Centrale-Lille-Makers/CdFdR-Carte-electronique/CdFdR.kicad_pcb

## KiCad design CdFdR.kicad_pcb (2025-05-16)

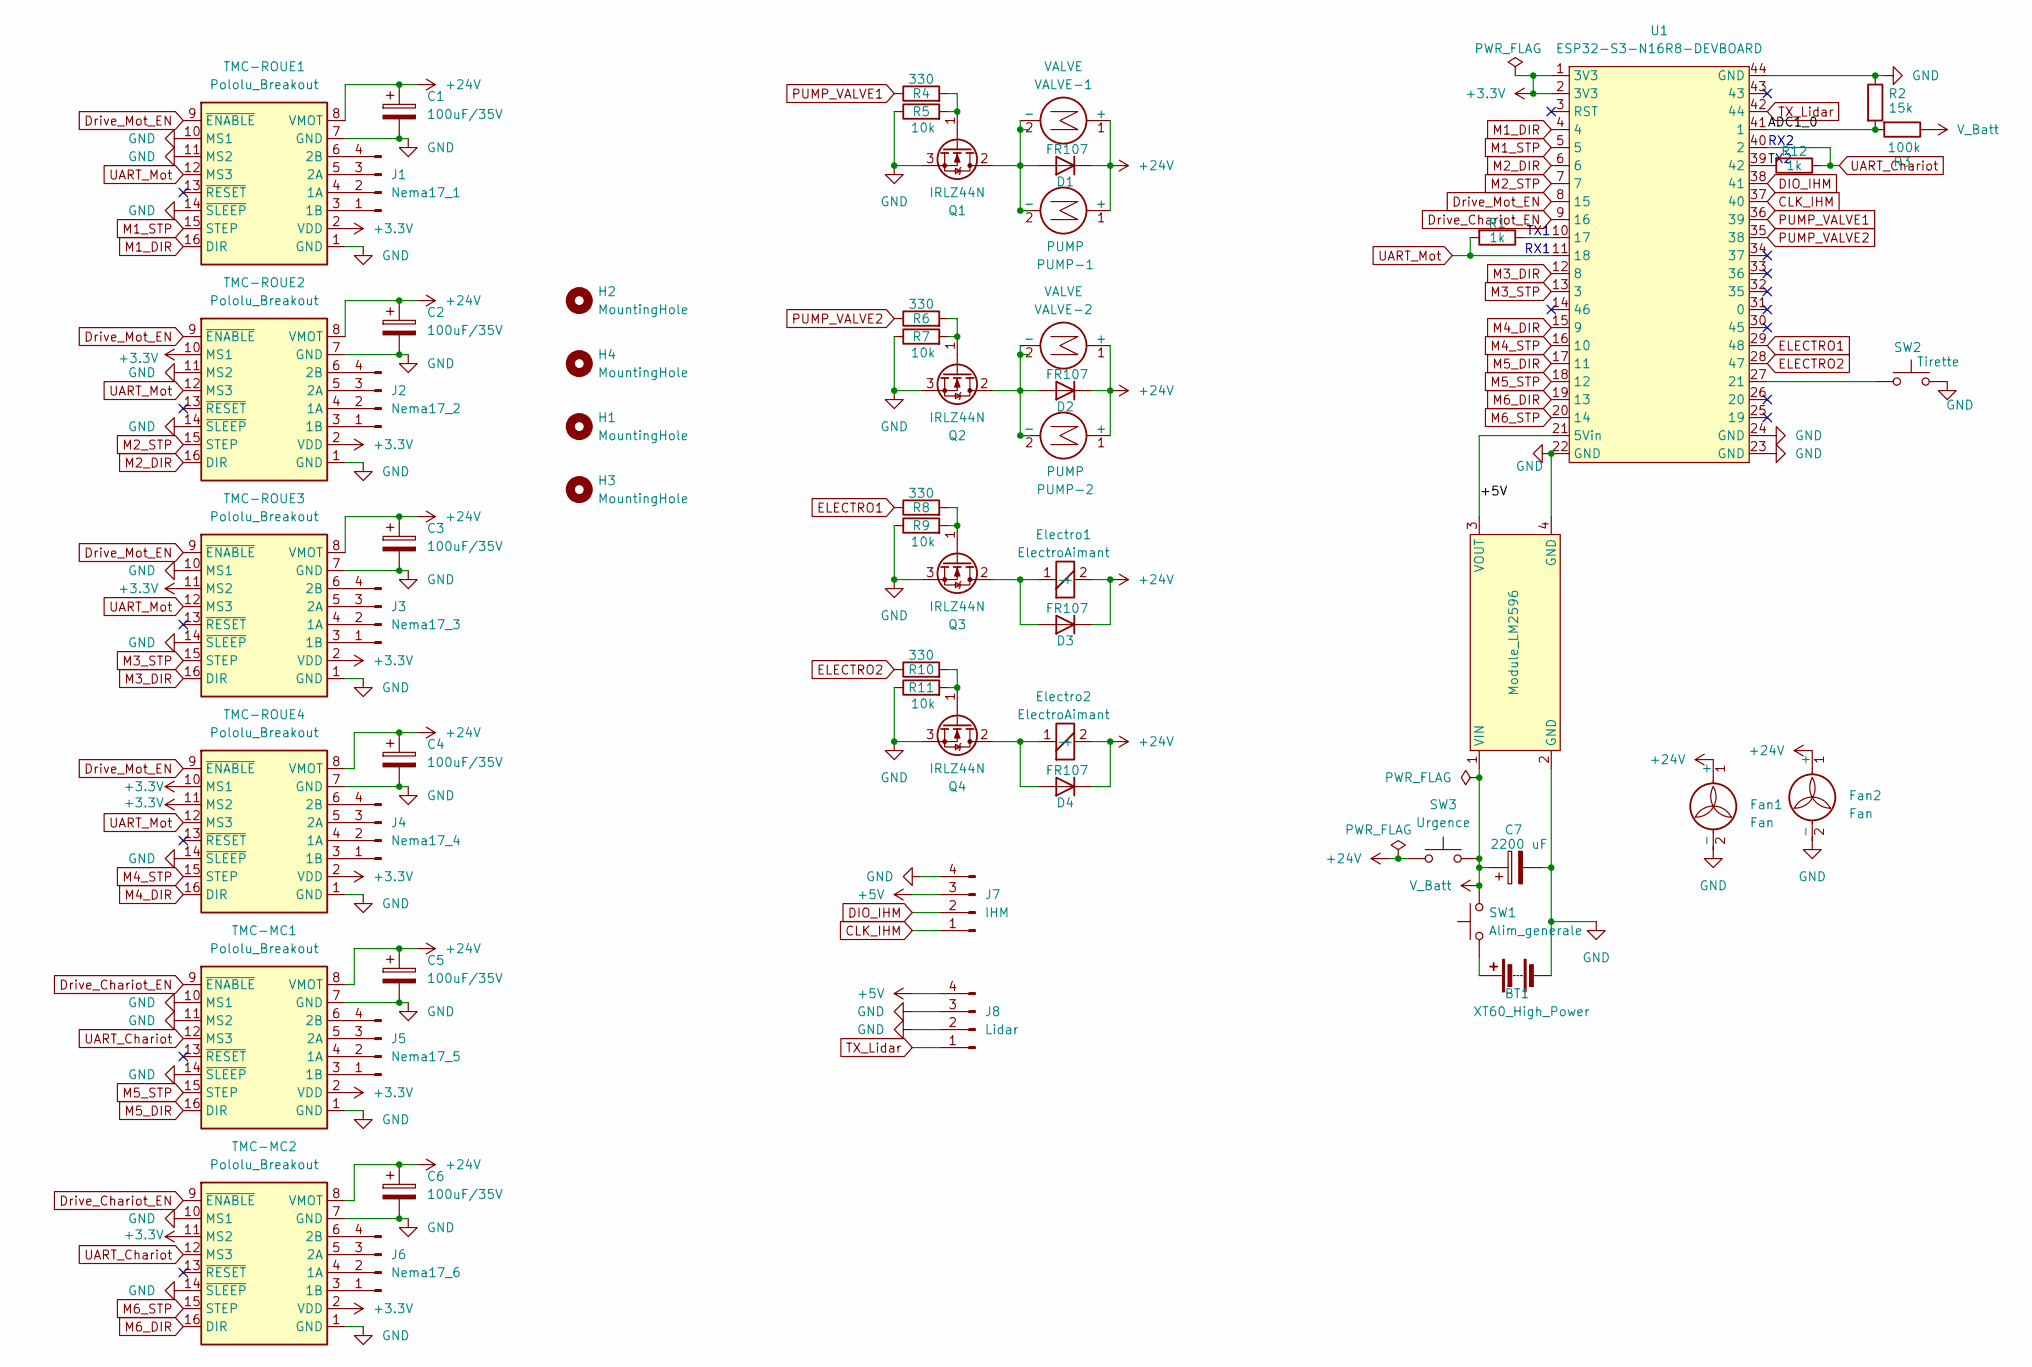
[picture p1: schematic CdFdR.kicad_sch, Carte de commande principale]

Parts:
BT1: XT60_High_Power; AMASS_XT60-M_1x02_P7.20mm_Vertical
C1, C2, C3, C4, C5, C6: 100uF/35V; CP_Radial_D6.3mm_P2.50mm
C7: 2200 uF; CP_Radial_D16.0mm_P7.50mm
D1, D2, D3, D4: FR107; D_DO-41_SOD81_P7.62mm_Horizontal
Electro1, Electro2: ElectroAimant; JST_XH_B2B-XH-A_1x02_P2.50mm_Vertical
Fan1, Fan2: Fan; JST_XH_B2B-XH-A_1x02_P2.50mm_Vertical
H1, H2, H3, H4: MountingHole; MountingHole_3.2mm_M3
J1: Nema17_1; JST_XH_B4B-XH-A_1x04_P2.50mm_Vertical
J2: Nema17_2; JST_XH_B4B-XH-A_1x04_P2.50mm_Vertical
J3: Nema17_3; JST_XH_B4B-XH-A_1x04_P2.50mm_Vertical
J4: Nema17_4; JST_XH_B4B-XH-A_1x04_P2.50mm_Vertical
J5: Nema17_5; JST_XH_B4B-XH-A_1x04_P2.50mm_Vertical
J6: Nema17_6; JST_XH_B4B-XH-A_1x04_P2.50mm_Vertical
J7: IHM; JST_XH_B4B-XH-A_1x04_P2.50mm_Vertical
J8: Lidar; JST_XH_B4B-XH-A_1x04_P2.50mm_Vertical
Module_LM2596: LM2596; LM2596 Converter DC-DC
PUMP-1, PUMP-2: PUMP; JST_XH_B2B-XH-A_1x02_P2.50mm_Vertical
Q1, Q2, Q3, Q4: IRLZ44N; TO-220-3_Vertical
R1, R12: 1k; R_Axial_DIN0207_L6.3mm_D2.5mm_P7.62mm_Horizontal
R2: 15k; R_Axial_DIN0207_L6.3mm_D2.5mm_P7.62mm_Horizontal
R3: 100k; R_Axial_DIN0207_L6.3mm_D2.5mm_P7.62mm_Horizontal
R4, R6, R8, R10: 330; R_Axial_DIN0207_L6.3mm_D2.5mm_P7.62mm_Horizontal
R5, R7, R9, R11: 10k; R_Axial_DIN0207_L6.3mm_D2.5mm_P7.62mm_Horizontal
SW1: Alim_generale; AMASS_XT60-F_1x02_P7.20mm_Vertical
SW2: Tirette; JST_XH_B2B-XH-A_1x02_P2.50mm_Vertical
SW3: Urgence; AMASS_XT60-F_1x02_P7.20mm_Vertical
TMC-MC1, TMC-MC2: Pololu_Breakout; Pololu_Breakout-16_15.2x20.3mm_Better_Silkscreen
TMC-ROUE1, TMC-ROUE2, TMC-ROUE3, TMC-ROUE4: Pololu_Breakout; Pololu_Breakout-16_15.2x20.3mm_Better_Silkscreen
U1: ESP32-S3-N16R8-DEVBOARD; ESP32-S3-DevKit
VALVE-1, VALVE-2: VALVE; JST_XH_B2B-XH-A_1x02_P2.50mm_Vertical

Connections:
+3.3V: TMC-MC1.2 (VDD), TMC-MC2.2 (VDD), TMC-MC2.11 (MS2), TMC-ROUE1.2 (VDD), TMC-ROUE2.2 (VDD), TMC-ROUE2.10 (MS1), TMC-ROUE3.2 (VDD), TMC-ROUE3.11 (MS2), TMC-ROUE4.2 (VDD), TMC-ROUE4.10 (MS1), TMC-ROUE4.11 (MS2), U1.1 (3V3), U1.2 (3V3)
+5V: J7.3, J8.4, Module_LM2596.3 (VOUT), U1.21 (5Vin)
+24V: C1.1, C2.1, C3.1, C4.1, C5.1, C6.1, D1.1 (K), D2.1 (K), D3.1 (K), D4.1 (K), Electro1.2 (+), Electro2.2 (+), Fan1.1 (+), Fan2.1 (+), PUMP-1.1 (+), PUMP-2.1 (+), SW3.1, TMC-MC1.8 (VMOT), TMC-MC2.8 (VMOT), TMC-ROUE1.8 (VMOT), TMC-ROUE2.8 (VMOT), TMC-ROUE3.8 (VMOT), TMC-ROUE4.8 (VMOT), VALVE-1.1 (+), VALVE-2.1 (+)
/ADC1_0: R2.2, R3.2, U1.41 (1)
CLK_IHM: J7.1, U1.37 (40)
DIO_IHM: J7.2, U1.38 (41)
Drive_Chariot_EN: TMC-MC1.9 (~ENABLE), TMC-MC2.9 (~ENABLE), U1.9 (16)
Drive_Mot_EN: TMC-ROUE1.9 (~ENABLE), TMC-ROUE2.9 (~ENABLE), TMC-ROUE3.9 (~ENABLE), TMC-ROUE4.9 (~ENABLE), U1.8 (15)
ELECTRO1: R8.1, U1.29 (48)
ELECTRO2: R10.1, U1.28 (47)
GND: BT1.2 (-), C1.2, C2.2, C3.2, C4.2, C5.2, C6.2, C7.2, Fan1.2 (-), Fan2.2 (-), J7.4, J8.2, J8.3, Module_LM2596.2 (GND), Module_LM2596.4 (GND), Q1.3 (S), Q2.3 (S), Q3.3 (S), Q4.3 (S), R2.1, R5.1, R7.1, R9.1, R11.1, SW2.2, TMC-MC1.1 (GND), TMC-MC1.7 (GND), TMC-MC1.10 (MS1), TMC-MC1.11 (MS2), TMC-MC1.14 (~SLEEP), TMC-MC2.1 (GND), TMC-MC2.7 (GND), TMC-MC2.10 (MS1), TMC-MC2.14 (~SLEEP), TMC-ROUE1.1 (GND), TMC-ROUE1.7 (GND), TMC-ROUE1.10 (MS1), TMC-ROUE1.11 (MS2), TMC-ROUE1.14 (~SLEEP), TMC-ROUE2.1 (GND), TMC-ROUE2.7 (GND), TMC-ROUE2.11 (MS2), TMC-ROUE2.14 (~SLEEP), TMC-ROUE3.1 (GND), TMC-ROUE3.7 (GND), TMC-ROUE3.10 (MS1), TMC-ROUE3.14 (~SLEEP), TMC-ROUE4.1 (GND), TMC-ROUE4.7 (GND), TMC-ROUE4.14 (~SLEEP), U1.22 (GND), U1.23 (GND), U1.24 (GND), U1.44 (GND)
M1_DIR: TMC-ROUE1.16 (DIR), U1.4
M1_STP: TMC-ROUE1.15 (STEP), U1.5
M2_DIR: TMC-ROUE2.16 (DIR), U1.6
M2_STP: TMC-ROUE2.15 (STEP), U1.7
M3_DIR: TMC-ROUE3.16 (DIR), U1.12 (8)
M3_STP: TMC-ROUE3.15 (STEP), U1.13 (3)
M4_DIR: TMC-ROUE4.16 (DIR), U1.15 (9)
M4_STP: TMC-ROUE4.15 (STEP), U1.16 (10)
M5_DIR: TMC-MC1.16 (DIR), U1.17 (11)
M5_STP: TMC-MC1.15 (STEP), U1.18 (12)
M6_DIR: TMC-MC2.16 (DIR), U1.19 (13)
M6_STP: TMC-MC2.15 (STEP), U1.20 (14)
unnamed: BT1.1 (+), SW1.1
unnamed: D1.2 (A), PUMP-1.2 (-), Q1.2 (D), VALVE-1.2 (-)
unnamed: D2.2 (A), PUMP-2.2 (-), Q2.2 (D), VALVE-2.2 (-)
unnamed: D3.2 (A), Electro1.1 (-), Q3.2 (D)
unnamed: D4.2 (A), Electro2.1 (-), Q4.2 (D)
unnamed: J1.1, TMC-ROUE1.3 (1B)
unnamed: J1.2, TMC-ROUE1.4 (1A)
unnamed: J1.3, TMC-ROUE1.5 (2A)
unnamed: J1.4, TMC-ROUE1.6 (2B)
unnamed: J2.1, TMC-ROUE2.3 (1B)
unnamed: J2.2, TMC-ROUE2.4 (1A)
unnamed: J2.3, TMC-ROUE2.5 (2A)
unnamed: J2.4, TMC-ROUE2.6 (2B)
unnamed: J3.1, TMC-ROUE3.3 (1B)
unnamed: J3.2, TMC-ROUE3.4 (1A)
unnamed: J3.3, TMC-ROUE3.5 (2A)
unnamed: J3.4, TMC-ROUE3.6 (2B)
unnamed: J4.1, TMC-ROUE4.3 (1B)
unnamed: J4.2, TMC-ROUE4.4 (1A)
unnamed: J4.3, TMC-ROUE4.5 (2A)
unnamed: J4.4, TMC-ROUE4.6 (2B)
unnamed: J5.1, TMC-MC1.3 (1B)
unnamed: J5.2, TMC-MC1.4 (1A)
unnamed: J5.3, TMC-MC1.5 (2A)
unnamed: J5.4, TMC-MC1.6 (2B)
unnamed: J6.1, TMC-MC2.3 (1B)
unnamed: J6.2, TMC-MC2.4 (1A)
unnamed: J6.3, TMC-MC2.5 (2A)
unnamed: J6.4, TMC-MC2.6 (2B)
unnamed: Q1.1 (G), R4.2, R5.2
unnamed: Q2.1 (G), R6.2, R7.2
unnamed: Q3.1 (G), R8.2, R9.2
unnamed: Q4.1 (G), R10.2, R11.2
unnamed: R1.1, U1.10 (17)
unnamed: SW2.1, U1.27 (21)
unnamed: R12.2, U1.39 (42)
PUMP_VALVE1: R4.1, U1.36 (39)
PUMP_VALVE2: R6.1, U1.35 (38)
TX_Lidar: J8.1, U1.42 (44)
UART_Chariot: R12.1, TMC-MC1.12 (MS3), TMC-MC2.12 (MS3), U1.40 (2)
UART_Mot: R1.2, TMC-ROUE1.12 (MS3), TMC-ROUE2.12 (MS3), TMC-ROUE3.12 (MS3), TMC-ROUE4.12 (MS3), U1.11 (18)
V_Batt: C7.1, Module_LM2596.1 (VIN), R3.1, SW1.2, SW3.2

Notes on the sheet:
TX2
RX1
TX1
RX2

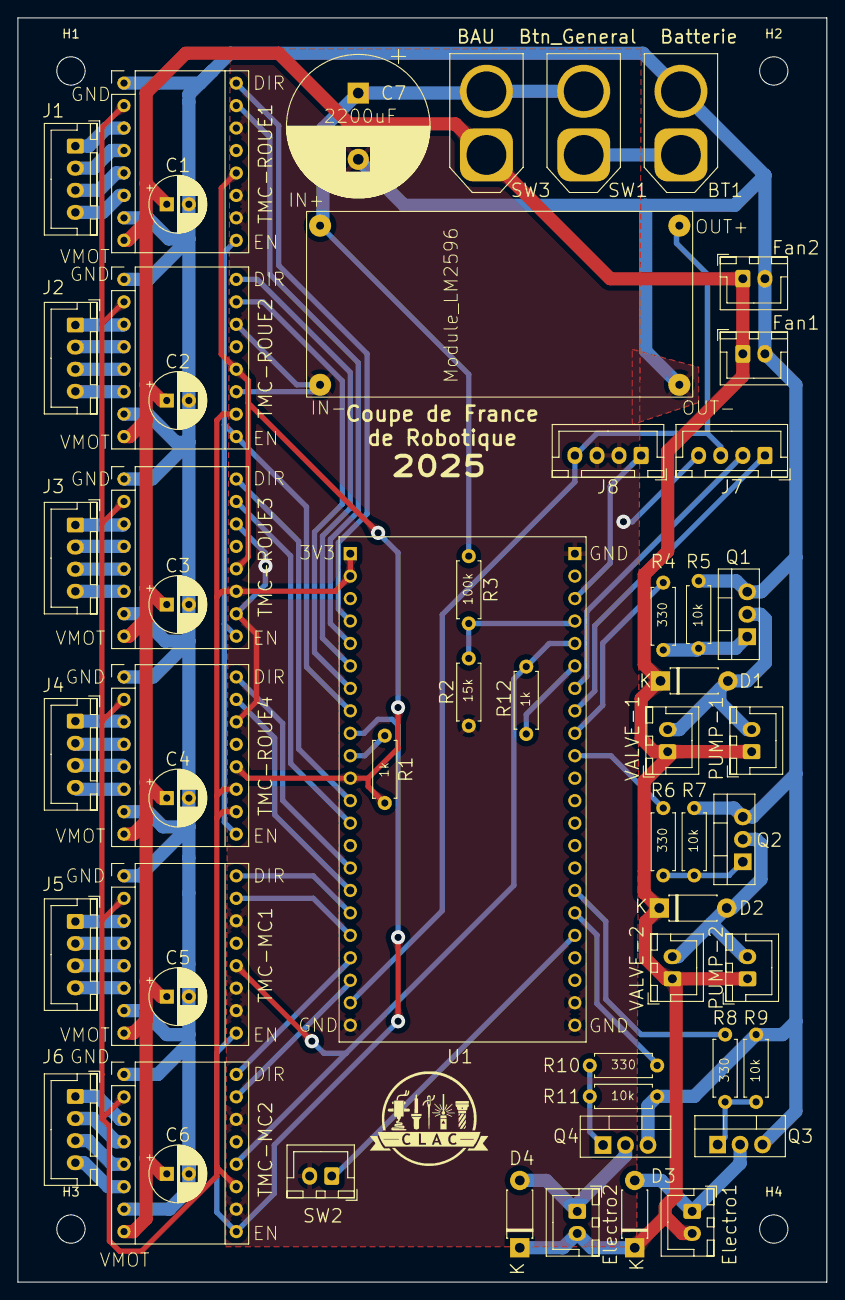
[picture p2: board CdFdR.kicad_pcb from above]

Board: 2 copper layers, 91.5 x 143.0 mm, 59 parts (0 on the bottom side), 65 nets.
