Centrale-Lille-Makers/CdFdR-Carte-electronique/(commit log)

2025-01-27 Rev .1
    [CdFdR.kicad_pcb, CdFdR.kicad_sch]
2025-02-14 Changed drivers uart code due to error on hand soldered board
    [CdFdR.kicad_pcb, CdFdR.kicad_sch]
2025-02-15 Correction des pins des moteurs pour être en accord avec carte soudé
    [CdFdR.kicad_pcb, CdFdR.kicad_sch]
2025-05-05 Ajout de composants
    Ajout de composants sur le schématic
    [CdFdR.kicad_sch]
2025-05-13 Version envoyé pour vérif
    [CdFdR.kicad_pcb, CdFdR.kicad_sch]
2025-05-15 Ajout de teardrops
    [CdFdR.kicad_pcb]
2025-05-16 Config pour commande
    [CdFdR-B_Cu.gbl, CdFdR-B_Mask.gbs, CdFdR-B_Paste.gbp, CdFdR-B_Silkscreen.gbo, CdFdR-Edge_Cuts.gm1, CdFdR-F_Cu.gtl, CdFdR-F_Mask.gts, CdFdR-F_Paste.gtp]
